elieassjaj/Mach3-based-industrial-CNC-controller/MOTION_ENGINE.md — Motion Engine Requirements and Design Constraints.md

# CNC5AX-ETH Motion Engine

## 1. Purpose

This document defines the **non-negotiable requirements, constraints, interfaces, and design objectives** for the motion-control subsystem of the CNC5AX-ETH controller.

The purpose of this document is **not** to prescribe a specific implementation.

The final motion-engine architecture, algorithms, timer allocation, DMA strategy, buffering mechanism, interpolation method, and real-time scheduling strategy must be selected during firmware development based on:

- Mach3 SDK behavior
- Project requirements
- STM32F407 capabilities
- STM32 official documentation
- Real-time performance analysis
- Determinism
- Measured timing margin
- Reliability and safety

The implementation must satisfy all fixed requirements in this document with a substantial engineering margin.

---

# 2. Target Hardware

```text
MCU:        STM32F407VGT6
CPU:        ARM Cortex-M4 with FPU
Axes:       5
Axes names: X, Y, Z, A, B
```

The authoritative hardware pin assignments are defined in:

```text
Docs/PINOUT.md
```

Do not duplicate or redefine the pin mapping in this document.

The firmware must use `Docs/PINOUT.md` as the authoritative source for the physical MCU pin assignments.

---

# 3. Motion Axes

The controller provides five real motion axes:

```text
X
Y
Z
A
B
```

All five axes are part of the required motion-control subsystem.

The requirement to guarantee three axes at maximum speed does **not** mean that the remaining two axes are optional or lower-priority.

The final implementation must support all five axes.

---

# 4. STEP Outputs

## 4.1 Electrical Behavior

All STEP outputs are:

```text
Active High
```

A STEP event is generated by a transition from:

```text
LOW → HIGH
```

The external stepper/servo drivers are primarily sensitive to the **rising edge** of the STEP signal rather than the exact pulse width.

The STEP output therefore must guarantee a clean and deterministic rising edge.

---

## 4.2 Maximum STEP Rate

The maximum reliable target STEP frequency is:

```text
2 MHz
```

This means a maximum nominal STEP period of:

```text
500 ns
```

The 2 MHz figure is the project-level maximum target for reliable operation and must be treated as a hard performance requirement.

### Multi-Axis Requirement

The motion engine must be designed so that:

```text
At least 3 axes
```

can operate simultaneously at:

```text
2 MHz STEP rate per axis
```

while maintaining reliable and deterministic operation.

This is a **minimum guaranteed capability**.

The remaining two axes must remain fully functional and must not be architecturally disadvantaged simply because the minimum simultaneous 2 MHz requirement is specified for three axes.

A stronger implementation that supports all five axes simultaneously at or near 2 MHz is preferable, but it must not be assumed or claimed without verification.

---

# 5. STEP Pulse Width

The external stepper/servo drivers are primarily sensitive to the rising edge of the STEP signal.

Therefore, the exact STEP pulse width is not a primary system-level constraint.

The design should nevertheless maintain a pulse width comfortably above:

```text
100 ns
```

as a practical safety margin.

The implementation must ensure that the generated pulse is:

- Clean
- Monotonic
- Deterministic
- Free from unintended glitches
- Long enough to satisfy the external driver's requirements

The exact pulse-generation method must be selected by the firmware implementation.

---

# 6. DIR Outputs

All DIR outputs are:

```text
Active High
```

The authoritative DIR pin mapping is defined in:

```text
Docs/PINOUT.md
```

The motion engine must treat the direction signal as a hardware-timed part of the motion-generation system rather than as an unrelated background GPIO operation.

---

# 7. DIR Timing Requirements

The minimum required timing margin for each direction change is:

```text
DIR setup time:  200 ns minimum
DIR hold time:   200 ns minimum
```

The implementation must guarantee at least these values between a DIR transition and the relevant STEP edge.

The actual firmware implementation should preferably provide additional margin rather than operating exactly at the minimum.

Conceptually:

```text
DIR change
    │
    ├────── ≥ 200 ns ──────►
    │
    │                        STEP rising edge
    ▼                              ↑
 DIR stable                first STEP event
```

The exact timing mechanism must be determined during implementation.

Software delays should not be used for hard real-time DIR timing when a deterministic hardware-based mechanism is available.

---

# 8. Hardware Timing Requirement

The STEP/DIR subsystem is a **hard real-time subsystem**.

The final architecture must ensure that Ethernet processing, application-level networking, diagnostics, logging, and other non-real-time operations cannot introduce unacceptable timing variation into STEP generation.

The repository architecture already establishes motion timing as a higher-priority concern than non-real-time processing.

The final implementation must preserve this principle.

---

# 9. STEP Pin Hardware Configuration

All STEP pins are connected to timer alternate-function outputs on the PCB.

According to the project hardware definition:

```text
STEP_X = PD0
STEP_Y = PD1
STEP_Z = PD2
STEP_A = PD3
STEP_B = PD4
```

The current hardware documentation also specifies that these pins are intended for high-speed pulse generation using hardware timers and DMA.

The exact timer/channel mapping must be taken from the authoritative project pinout and verified against the STM32F407 Datasheet and Reference Manual.

Do not infer timer assignments from the GPIO names alone.

---

# 10. Preferred Hardware Generation Strategy

The initial design direction is:

```text
Hardware Timer + DMA
```

However, the project does **not** predefine whether the final implementation must use:

- PWM mode
- Output Compare
- Toggle mode
- One-pulse generation
- DMA-driven GPIO/BSRR updates
- Timer + DMA waveform generation
- A combination of the above
- Another hardware-assisted architecture

The final method must be selected by the implementing AI/engineer based on measured and documented requirements.

### Selection Criteria

The chosen implementation must prioritize:

1. Deterministic STEP timing
2. Deterministic DIR timing
3. Low CPU overhead
4. Low interrupt frequency in the hard real-time path
5. Sufficient DMA bandwidth
6. Sufficient timer resolution
7. Multi-axis synchronization
8. Minimal timing jitter
9. Safe handling of direction changes
10. Reliable operation under maximum Ethernet traffic
11. Sufficient margin above the minimum requirements
12. Maintainability and debuggability

Do not select PWM merely because the pins are connected to timer PWM-capable outputs.

PWM is one possible implementation technique, not a mandatory architectural requirement.

---

# 11. Timer and DMA Architecture Must Be Derived

The final timer and DMA allocation must be determined during implementation.

The implementation must inspect:

```text
STM32F407 Datasheet
STM32F407 Reference Manual
STM32F405/407 Errata
STM32F4 HAL/LL documentation and source
STM32CubeF4 package
Docs/PINOUT.md
```

The implementation must determine:

- Which timers can drive each STEP pin
- Which timer channels correspond to those pins
- Which timers can operate independently
- Which DMA streams/channels can service the required requests
- DMA conflicts
- Timer synchronization options
- Timer clock frequencies
- Counter resolution
- Maximum practical STEP frequency
- DMA transfer rate
- Interrupt load
- Memory requirements
- Inter-axis synchronization capability

No timer or DMA assignment should be hard-coded in project documentation before this analysis has been completed.

---

# 12. Mach3 Command Source

The motion engine receives its motion requirements from the Mach3-side integration.

The exact command semantics must be derived from the **Mach3 SDK included in this repository**.

The implementing AI must inspect:

```text
MACH3/
```

including:

- SDK documentation
- Header files
- API definitions
- Data structures
- Enumerations
- Constants
- Callbacks
- Official examples
- Relevant source code

The project must not assume the structure or meaning of Mach3 motion data based solely on generic knowledge of Mach3.

The SDK README explicitly requires verification of SDK APIs, structures, callbacks, timing behavior, memory ownership, communication mechanisms, and examples before implementation.

---

# 13. Motion Command Interpretation

The exact representation of motion commands is intentionally not fixed in this document.

The final implementation must determine from the Mach3 SDK and project architecture whether the host-side integration provides information such as:

- Position targets
- Position increments
- Velocity
- Step counts
- Trajectory information
- Timing information
- Motion state
- Jog information
- Feed information
- Stop conditions
- Input state
- Other engine-specific data

The firmware must implement the smallest and most deterministic data path necessary to satisfy the actual Mach3 interface requirements.

---

# 14. Motion Planning and Interpolation

The project does not predefine the final mathematical implementation of:

- Multi-axis interpolation
- Velocity profile generation
- Acceleration
- Deceleration
- Jerk limiting
- Look-ahead
- Segment generation
- Trajectory buffering

These decisions must be derived from the actual Mach3 SDK behavior and the resulting host-controller data model.

The implementation must determine which motion responsibilities belong to:

```text
Mach3 / Host PC
```

and which responsibilities must be performed by:

```text
STM32 Motion Engine
```

The same operation must not be unnecessarily duplicated in both systems.

---

# 15. Five-Axis Synchronization

All five axes must be treated as part of one coordinated motion system.

When multiple axes participate in the same motion segment, the generated STEP streams must preserve the required relationship between the axes.

The exact interpolation method must be selected during implementation.

The final implementation should be evaluated for:

- Position accuracy
- Timing accuracy
- Axis synchronization
- Velocity consistency
- Acceleration behavior
- Segment-to-segment continuity
- Maximum step rate
- Jitter
- Buffer behavior

The implementation must not sacrifice multi-axis correctness merely to achieve the maximum STEP rate.

---

# 16. Motion Buffering

The final buffering strategy is intentionally not fixed.

The implementation must determine whether the architecture requires:

- Command buffering
- Trajectory buffering
- Motion segment buffering
- STEP timing buffering
- DMA double buffering
- Ring buffers
- Queue-based scheduling
- Another deterministic buffering mechanism

The size and depth of the buffer must be derived from:

- Mach3 command rate
- Network packet rate
- Worst-case network latency
- Packet loss
- Processing time
- Motion segment duration
- DMA requirements
- Available RAM

The implementation must provide sufficient margin to prevent underflow during normal operation.

---

# 17. Ethernet and Motion Separation

The Ethernet subsystem uses:

```text
LAN8720A
    ↓
RMII
    ↓
STM32F407 Ethernet MAC
    ↓
DMA
    ↓
LwIP
    ↓
UDP
```

The project Ethernet documentation defines the network path and explicitly requires that Ethernet processing must not compromise deterministic motion timing.

The motion engine must therefore be isolated from network processing as much as practical.

The preferred conceptual relationship is:

```text
Ethernet
   │
   ▼
UDP / Protocol
   │
   ▼
Motion Command Buffer
   │
   ▼
Motion Engine
   │
   ▼
Hardware Timer / DMA
   │
   ▼
STEP / DIR
```

The Ethernet callback must not become the STEP-generation mechanism.

---

# 18. Real-Time Priority

The final implementation must assign priorities according to actual timing requirements.

The following general priority principle applies:

```text
Hard real-time motion timing
        ↓
Motion state / critical safety handling
        ↓
Motion data preparation
        ↓
Ethernet processing
        ↓
Diagnostics / non-real-time tasks
```

The exact interrupt priority values must be derived from the final implementation and verified experimentally.

Do not choose priorities arbitrarily.

---

# 19. CPU Load

The motion engine must be designed to leave sufficient CPU resources for:

- Ethernet processing
- LwIP
- Mach3 protocol handling
- I/O handling
- Safety monitoring
- Diagnostics
- Status feedback
- Future firmware expansion

The design must therefore avoid unnecessary high-frequency CPU interrupts.

A solution that technically generates 2 MHz STEP pulses but consumes excessive CPU time is not considered a robust solution.

---

# 20. Jitter

The exact maximum acceptable STEP jitter is currently:

```text
TBD
```

The implementation must nevertheless minimize jitter as much as practical.

The design must not depend on an unverified assumption that the CPU can service a software interrupt every STEP event.

The final system should preferentially use hardware peripherals to control the timing-critical waveform.

Once the motion architecture has been selected, the maximum observed timing deviation must be measured and documented.

---

# 21. Motion Safety

The motion engine must have explicit behavior for safety-related events.

The exact Mach3/software interaction and safety semantics must be derived from the SDK and project requirements.

Potential events include:

- Emergency stop
- Limit switch
- Feed hold
- Normal stop
- Fault condition
- Communication timeout
- Motion buffer underflow
- Invalid motion command

The final implementation must define deterministic behavior for each required event.

No safety-related behavior should be invented silently.

---

# 22. Communication Failure

The exact behavior after:

- Lost packet
- Delayed packet
- Out-of-order packet
- Invalid packet
- Duplicate packet
- Communication timeout
- Ethernet link loss

must be derived from the Mach3 integration and final communication protocol.

Possible behaviors include:

```text
Continue from buffered motion
Controlled stop
Immediate stop
Hold current state
Enter fault state
```

The final implementation must choose behavior based on the actual system requirements and safety analysis.

It must not assume that UDP itself provides delivery guarantees.

---

# 23. Position Tracking

The final implementation must determine from the Mach3 SDK and motion architecture whether the STM32 must maintain:

- Commanded position
- Generated position
- Step count
- Axis position
- Motion segment position
- Host synchronization state

The required representation, width, units, and update mechanism must be determined during implementation.

Use sufficiently wide integer representations where required to prevent overflow during long machine operation.

---

# 24. Direction Handling

Direction changes are part of the hard real-time motion path.

The implementation must guarantee:

```text
DIR setup ≥ 200 ns
DIR hold  ≥ 200 ns
```

around the relevant STEP edge.

The final implementation must ensure that:

- DIR cannot change accidentally during a STEP event
- A direction transition does not create a spurious STEP
- The first STEP after a direction change satisfies the required setup time
- The last STEP before a direction change satisfies the required hold time

The exact implementation method is TBD.

---

# 25. Negative and Positive Motion

Because DIR is Active High, the final implementation must define a consistent relationship between:

```text
Motion direction
        ↓
Axis sign
        ↓
DIR level
```

The exact sign convention must be taken from the final machine configuration and Mach3 integration.

Do not assume:

```text
DIR = 1 → positive
DIR = 0 → negative
```

unless the project hardware and Mach3 configuration explicitly establish that convention.

---

# 26. CoreXY / Kinematic Transformations

The project must not assume that all motion transformation occurs at the Ethernet or protocol layer.

The exact kinematic model must be derived from the final Mach3 configuration and hardware architecture.

If a kinematic transformation such as CoreXY is required, it must be implemented at the appropriate motion-control layer rather than being duplicated across unrelated layers.

The authoritative machine kinematic model must be documented before implementation.

---

# 27. Implementation Independence

The following are intentionally **not fixed** by this document:

```text
Timer mode
PWM vs Output Compare
DMA architecture
DMA buffering
Interrupt frequency
Timer allocation
Motion interpolation algorithm
Acceleration algorithm
Deceleration algorithm
Jerk handling
Buffer depth
Position representation
Communication timeout
Packet scheduling
RTOS vs Bare-Metal
Exact interrupt priorities
```

The AI implementing the final firmware must evaluate these choices against the fixed requirements.

---

# 28. Engineering Objective

The goal is not merely to produce a motion engine that can theoretically reach:

```text
2 MHz
```

The objective is to produce a motion engine that can do so:

- Reliably
- Deterministically
- With low jitter
- With substantial timing margin
- Under maximum expected Ethernet traffic
- With simultaneous multi-axis operation
- Without unsafe race conditions
- Without excessive CPU usage
- Without depending on fragile timing assumptions

The implementation should target **headroom**, not merely the minimum passing condition.

---

# 29. Required Verification

Before considering the motion engine complete, the implementation must be verified experimentally.

At minimum, testing should cover:

### STEP Timing

- Maximum STEP frequency
- Minimum practical frequency
- STEP pulse width
- STEP edge integrity
- Timing jitter

### Multi-Axis Operation

At minimum:

```text
3 axes × 2 MHz STEP
```

must be demonstrated reliably.

The remaining two axes must also be tested under concurrent operation.

Where practical, test:

```text
5 axes simultaneously
```

under representative worst-case conditions.

### DIR Timing

Verify:

```text
DIR setup ≥ 200 ns
DIR hold  ≥ 200 ns
```

under worst-case operating conditions.

### Ethernet Load

Motion timing must be measured while Ethernet is under realistic and worst-case expected traffic.

### CPU Load

Measure CPU utilization during:

- Idle
- Normal motion
- High-rate motion
- Multi-axis motion
- High Ethernet traffic
- Maximum STEP operation

### Stress Conditions

The final design should be tested with combinations of:

```text
Maximum STEP rate
+
Multiple active axes
+
Continuous Ethernet traffic
+
Motion buffer activity
+
I/O activity
+
Status transmission
```

The objective is to verify that the real-time motion subsystem remains deterministic.

---

# 30. Acceptance Criteria

The motion engine is considered compliant only when all fixed requirements are satisfied.

## Mandatory Requirements

| Requirement | Target |
|---|---|
| Axes | X, Y, Z, A, B |
| Maximum STEP rate | 2 MHz |
| Minimum guaranteed simultaneous axes at 2 MHz | 3 |
| STEP polarity | Active High |
| DIR polarity | Active High |
| STEP pulse width | >100 ns preferred practical margin |
| DIR setup time | ≥200 ns |
| DIR hold time | ≥200 ns |
| Timing-critical generation | Hardware-assisted |
| Ethernet impact on STEP timing | Must not compromise determinism |

The minimum guaranteed simultaneous three-axis requirement must be demonstrated on the final hardware.

---

# 31. Documentation Sources

The motion engine implementation must be based on the following sources.

## Project Documentation

```text
Docs/PINOUT.md
Docs/SYSTEM_ARCHITECTURE.md
Docs/ethernet.md
MACH3/SDK_README.MD
```

## STM32 Documentation

```text
STM32_DOCs/
```

including:

- STM32F407 Datasheet
- STM32F407 Reference Manual
- Cortex-M4 Programming Manual
- STM32F405/407 Errata
- Relevant STM32 Application Notes

## Software References

Use the official:

- STM32F4 HAL/LL drivers
- STM32CubeF4 package
- Relevant LwIP documentation/source
- Mach3 SDK included in this repository

---

# 32. AI Development Instructions

This document is specifically intended to guide AI-assisted firmware development.

The AI must follow these rules.

### Rule 1 — Do not change fixed requirements

The values explicitly marked as project requirements must not be changed by the implementation.

This includes:

```text
5 axes
2 MHz maximum target
3 axes minimum simultaneous at 2 MHz
STEP Active High
DIR Active High
DIR setup ≥200 ns
DIR hold ≥200 ns
```

---

### Rule 2 — Do not invent unspecified requirements

If a required value is not defined here, the AI must not silently create one.

Examples:

```text
Maximum jitter
Buffer size
Timer allocation
DMA stream
Interrupt priority
Timeout
Acceleration profile
Communication behavior
```

These must either:

1. Be derived from an authoritative source,
2. Be experimentally determined,
3. Be explicitly proposed as an implementation decision.

---

### Rule 3 — Read the Mach3 SDK before implementing the host interface

The AI must inspect the complete Mach3 SDK material relevant to motion control before defining:

- Motion command structures
- Host-controller synchronization
- Position handling
- Motion timing
- Feed/velocity handling
- Jogging
- Stop behavior
- Input handling
- Feedback

Do not infer these from generic Mach3 knowledge.

---

### Rule 4 — Verify every hardware-dependent decision

Before selecting a timer, DMA stream, channel, GPIO mode, or alternate function, verify it against:

```text
PINOUT.md
+
STM32F407 Datasheet
+
RM0090
+
STM32 Errata
```

---

### Rule 5 — Optimize for margin

The implementation should not be optimized merely to reach the specification boundary.

Where feasible, target:

```text
Required performance
        ↓
Engineering margin
        ↓
Measured worst-case performance
```

The final implementation must retain sufficient margin for:

- Interrupt latency
- DMA contention
- Ethernet traffic
- Memory access
- Future firmware additions
- Worst-case execution paths

---

### Rule 6 — Do not force PWM without analysis

The hardware provides timer alternate-function outputs for the STEP pins.

This does **not** automatically mean PWM is the optimal STEP-generation technique.

The AI must compare appropriate approaches and select the one that provides the best combination of:

- Determinism
- Synchronization
- DMA efficiency
- CPU efficiency
- DIR timing
- Multi-axis scalability
- Reliability

---

### Rule 7 — Prefer hardware timing

When a timing requirement belongs to the STEP/DIR waveform itself, prefer deterministic hardware peripherals over software delays or high-frequency polling.

CPU-based timing must not be selected simply because it is easier to implement.

---

### Rule 8 — Measure before claiming compliance

A theoretical calculation is not sufficient to claim:

```text
3 × 2 MHz
```

or any other final performance target.

The final implementation must be tested on the actual hardware.

---

# 33. Implementation Decision Record

When the final architecture is selected, document the major decisions here or in a dedicated implementation document.

At minimum document:

```text
Timer allocation:
DMA allocation:
STEP generation mode:
DIR generation method:
Motion buffer architecture:
Interpolation method:
Position representation:
Interrupt priorities:
Maximum measured STEP rate:
Maximum measured simultaneous axis rate:
Measured jitter:
Measured CPU load:
Ethernet stress result:
```

This information should be updated after implementation and validation.

---

# 34. Final Design Principle

The motion engine must be treated as the **highest-priority real-time subsystem** of the CNC controller.

The final implementation should follow this principle:

```text
                    MACH3
                      │
                      ▼
                Ethernet / UDP
                      │
                      ▼
               Motion Protocol
                      │
                      ▼
              Motion Processing
                      │
             ┌────────┴────────┐
             ▼                 ▼
        Axis Planning       Buffering
             │                 │
             └────────┬────────┘
                      ▼
              Hardware Timing
              Timer / DMA
                      │
                      ▼
                  STEP / DIR
                      │
              ┌───────┼───────┐
              ▼       ▼       ▼
              X ...           B
```

The network stack, protocol parser, diagnostics, and other non-real-time firmware must be designed around the motion engine rather than allowing them to determine its timing behavior.

The final architecture must satisfy the fixed project requirements while providing substantial real-time performance and reliability margin.
