elieassjaj/Mach3-based-industrial-CNC-controller/Docs/MOTION-ENGINE.md

# CNC5AX-ETH Motion Engine

## 1. Purpose

This document defines the **non-negotiable requirements, constraints, interfaces, and design objectives** for the motion-control subsystem of the CNC5AX-ETH controller.

The purpose of this document is **not** to prescribe a specific implementation.

The final motion-engine architecture, algorithms, timer allocation, DMA strategy, buffering mechanism, interpolation method, and real-time scheduling strategy must be selected during firmware development based on:

- Mach3 SDK behavior
- Project requirements
- STM32F407 capabilities
- STM32 official documentation
- Real-time performance analysis
- Determinism
- Measured timing margin
- Reliability and safety

The implementation must satisfy all fixed requirements in this document with a substantial engineering margin.

---

# 2. Target Hardware

```text
MCU:        STM32F407VGT6
CPU:        ARM Cortex-M4 with FPU
Axes:       5
Axes names: X, Y, Z, A, B
```

The authoritative hardware pin assignments are defined in:

```text
Docs/PINOUT.md
```

Do not duplicate or redefine the pin mapping in this document.

The firmware must use `Docs/PINOUT.md` as the authoritative source for the physical MCU pin assignments.

---

# 3. Motion Axes

The controller provides five real motion axes:

```text
X
Y
Z
A
B
```

All five axes are part of the required motion-control subsystem.

The requirement to guarantee three axes at maximum speed does **not** mean that the remaining two axes are optional or lower-priority.

The final implementation must support all five axes.

---

# 4. STEP Outputs

## 4.1 Electrical Behavior

All STEP outputs are:

```text
Active High
```

A STEP event is generated by a transition from:

```text
LOW → HIGH
```

The external stepper/servo drivers are primarily sensitive to the **rising edge** of the STEP signal rather than the exact pulse width.

The STEP output therefore must guarantee a clean and deterministic rising edge.

---

## 4.2 Maximum STEP Rate

The maximum reliable target STEP frequency is:

```text
2 MHz
```

This means a maximum nominal STEP period of:

```text
500 ns
```

The 2 MHz figure is the project-level maximum target for reliable operation and must be treated as a hard performance requirement.

### Multi-Axis Requirement

The motion engine must be designed so that:

```text
At least 3 axes
```

can operate simultaneously at:

```text
2 MHz STEP rate per axis
```

while maintaining reliable and deterministic operation.

This is a **minimum guaranteed capability**.

The remaining two axes must remain fully functional and must not be architecturally disadvantaged simply because the minimum simultaneous 2 MHz requirement is specified for three axes.

A stronger implementation that supports all five axes simultaneously at or near 2 MHz is preferable, but it must not be assumed or claimed without verification.

---

# 5. STEP Pulse Width

The external stepper/servo drivers are primarily sensitive to the rising edge of the STEP signal.

Therefore, the exact STEP pulse width is not a primary system-level constraint.

The design should nevertheless maintain a pulse width comfortably above:

```text
100 ns
```

as a practical safety margin.

The implementation must ensure that the generated pulse is:

- Clean
- Monotonic
- Deterministic
- Free from unintended glitches
- Long enough to satisfy the external driver's requirements

---

# 6. DIR Outputs

All DIR outputs are:

```text
Active High
```

The authoritative DIR pin mapping is defined in:

```text
Docs/PINOUT.md
```

The motion engine must treat the direction signal as a hardware-timed part of the motion-generation system rather than as an unrelated background GPIO operation.

---

# 7. DIR Timing Requirements

The minimum required timing margin for each direction change is:

```text
DIR setup time:  200 ns minimum
DIR hold time:   200 ns minimum
```

The implementation must guarantee at least these values between a DIR transition and the relevant STEP edge.

The actual firmware implementation should preferably provide additional margin rather than operating exactly at the minimum.

Conceptually:

```text
DIR change
    │
    ├────── ≥ 200 ns ──────►
    │
    │                        STEP rising edge
    ▼                              ↑
 DIR stable                first STEP event
```

The exact timing mechanism must be determined during implementation.

Software delays should not be used for hard real-time DIR timing when a deterministic hardware-based mechanism is available.

---

# 8. Hardware Timing Requirement

The STEP/DIR subsystem is a **hard real-time subsystem**.

The final architecture must ensure that Ethernet processing, application-level networking, diagnostics, logging, and other non-real-time operations cannot introduce unacceptable timing variation into STEP generation.

The repository architecture already establishes motion timing as a higher-priority concern than non-real-time processing.

The final implementation must preserve this principle.

---

# 9. STEP Pin Hardware Configuration

According to the project hardware definition (`Docs/PINOUT.md`):

```text
STEP_X = PA8
STEP_Y = PA9
STEP_Z = PA10
STEP_A = PA11
STEP_B = PA12
```

All five STEP pins are on `GPIOA`, in sequential order (see ADR-005 in `Docs/FIRMWARE-ARCHITECTURE.md`). `PA8`–`PA11` have valid `TIM1_CH1`–`CH4` alternate functions; `PA12` has no TIM1 PWM-channel alternate function (only `TIM1_ETR`). Per Section 10, all five are deliberately configured as plain GPIO outputs and driven via DMA→BSRR rather than via any Alternate Function — because `PA8`–`PA11` share a single `TIM1` ARR (period), which would force axes X, Y, Z, and A onto one common STEP frequency.

The exact DMA stream/mask allocation must be taken from the authoritative project pinout and verified against the STM32F407 Datasheet and Reference Manual.

Do not infer timer/DMA assignments from the GPIO names alone.

---

## 10. STEP Generation Architecture

The STEP generation architecture is fixed as a **timer-triggered DMA to GPIO BSRR** design.

STEP outputs are configured as normal GPIO outputs. Timer PWM, Output Compare, Toggle mode, One-Pulse mode, and CPU-driven GPIO toggling are **not used** for STEP waveform generation.

The motion engine prepares time-ordered STEP events in DMA buffers. DMA transfers precomputed 32-bit values directly to the corresponding GPIO `BSRR` registers.

### Generation Path

```text
Motion Engine
      │
      ▼
STEP Event / BSRR Buffers
      │
      ▼
     DMA
      │
      ▼
GPIOx->BSRR
      │
      ▼
STEP Outputs
```

A base timer provides the deterministic DMA request timing:

```text
Base Timer Update Event
          │
          ▼
         DMA
          │
          ▼
GPIOx->BSRR
```

The timer therefore acts as the **DMA timing/request source**. It does not directly generate the STEP waveform and its output channels are not used as STEP outputs.

### BSRR-Based STEP Events

Each DMA transfer represents a predefined GPIO state transition. The transferred BSRR value may contain:

- GPIO set bits for STEP outputs that must become HIGH
- GPIO reset bits for STEP outputs that must become LOW
- Multiple axis transitions in the same transfer when required

This allows several axes sharing the same timing base to change state deterministically from a single scheduled event.

The STEP GPIO assignments are defined by `Docs/PINOUT.md`.

Current STEP output grouping is:

```text
GPIOA:
    PA8  = X_STEP
    PA9  = Y_STEP
    PA10 = Z_STEP
    PA11 = A_STEP
    PA12 = B_STEP
```

All STEP signals are on `GPIOA`, so the implementation only needs to account for `GPIOA->BSRR` transfers — a single DMA stream and a single 32-bit write per tick covers all five axes.

### Timing Requirements

The STEP generator must support:

- Maximum target STEP frequency: **2 MHz**
- Minimum guaranteed capability: **3 axes simultaneously at 2 MHz**
- STEP active state: HIGH
- Minimum practical STEP pulse width: greater than **100 ns**
- DIR setup time requirement: **200 ns minimum**
- DIR hold time requirement: **200 ns minimum**

At 2 MHz, the nominal STEP period is:

```text
T_STEP = 1 / 2 MHz = 500 ns
```

The implementation must preserve sufficient timing margin and must not depend on CPU execution latency for STEP edge generation.

### Determinism

Once a STEP event buffer has been committed for DMA execution, STEP timing must be independent of:

- Ethernet packet arrival timing
- LwIP processing
- UDP callbacks
- CPU scheduling jitter
- Background diagnostics
- Non-real-time application code

The CPU is responsible for preparing and managing motion data, while the timer-triggered DMA path is responsible for deterministic GPIO state updates.

---

## 11. Timer and DMA Resource Allocation

The STEP-generation architecture is fixed:

```text
Base Timer → DMA Request → GPIOx->BSRR
```

The exact STM32 peripheral allocation remains an implementation detail and must be selected according to the STM32F407VGT6 DMA request mapping, available DMA streams/channels, GPIO port usage, and conflicts with Ethernet and other peripherals.

### Fixed Architectural Requirements

The implementation must satisfy the following:

```text
STEP GPIO mode:
    GPIO Output Push-Pull

STEP waveform generation:
    DMA writes to GPIOx->BSRR

DMA timing source:
    Timer update event

STEP generation:
    Hardware-assisted

CPU-generated STEP edges:
    Not allowed

Timer PWM / Output Compare on STEP pins:
    Not used
```

### DMA Requirements

The DMA implementation must support deterministic writes to the GPIO BSRR registers.

All STEP outputs are on a single GPIO port, so the design needs only one DMA transfer path:

```text
GPIOA->BSRR
```

A single DMA stream, triggered by the base timer's Update event, covers all five axes with zero cross-axis timing skew (see ADR-005 in `Docs/FIRMWARE-ARCHITECTURE.md`). The second `TIM2_UP`-capable DMA1 slot is consequently free and available for a future DIR-DMA path, if the DIR generation method (Section 24/27) is later chosen to use one.

The exact DMA stream/channel selection is **TBD** and must be verified against the STM32F407 DMA mapping and all other active peripherals.

### Timer Requirements

The timer used for STEP DMA triggering must provide a deterministic update-event rate appropriate for the selected motion-event representation.

The timer is a **timing source for DMA requests only**.

The following must not be assumed:

- A timer channel must directly correspond to a STEP GPIO.
- A STEP GPIO must use a timer Alternate Function.
- PWM duty cycle is responsible for STEP pulse width.
- Output Compare directly drives STEP outputs.

Instead, the timer establishes the schedule from which DMA transfers update the GPIO BSRR registers.

### Resource Allocation Constraints

The final allocation must be checked for conflicts with:

- Ethernet MAC/LwIP DMA requirements
- Spindle PWM timer
- Other timer functions
- DMA streams and channels already required by the system
- GPIO availability
- Interrupt resources
- Memory/buffer placement and DMA accessibility

The final Timer/DMA selection is therefore an **implementation decision**, but the underlying architecture is not.

### Validation Requirements

The final implementation must be validated on real hardware for:

1. 2 MHz STEP operation
2. At least 3 axes simultaneously operating at 2 MHz
3. Correct STEP pulse width
4. Correct DIR setup and hold timing
5. Stable operation while Ethernet traffic is active
6. No missed or duplicated STEP events under maximum intended load

The 2 MHz requirement must not be considered verified from simulation, source code inspection, or theoretical timer/DMA capability alone.

---

# 12. Mach3 Command Source

The motion engine receives its motion requirements from the Mach3-side integration.

The exact command semantics must be derived from the **Mach3 SDK included in this repository**.

The implementing AI must inspect:

```text
MACH3/
```

including:

- SDK documentation
- Header files
- API definitions
- Data structures
- Enumerations
- Constants
- Callbacks
- Official examples
- Relevant source code

The project must not assume the structure or meaning of Mach3 motion data based solely on generic knowledge of Mach3.

The SDK README explicitly requires verification of SDK APIs, structures, callbacks, timing behavior, memory ownership, communication mechanisms, and examples before implementation.

---

# 13. Motion Command Interpretation

The exact representation of motion commands is intentionally not fixed in this document.

The final implementation must determine from the Mach3 SDK and project architecture whether the host-side integration provides information such as:

- Position targets
- Position increments
- Velocity
- Step counts
- Trajectory information
- Timing information
- Motion state
- Jog information
- Feed information
- Stop conditions
- Input state
- Other engine-specific data

The firmware must implement the smallest and most deterministic data path necessary to satisfy the actual Mach3 interface requirements.

---

# 14. Motion Planning and Interpolation

The project does not predefine the final mathematical implementation of:

- Multi-axis interpolation
- Velocity profile generation
- Acceleration
- Deceleration
- Jerk limiting
- Look-ahead
- Segment generation
- Trajectory buffering

These decisions must be derived from the actual Mach3 SDK behavior and the resulting host-controller data model.

The implementation must determine which motion responsibilities belong to:

```text
Mach3 / Host PC
```

and which responsibilities must be performed by:

```text
STM32 Motion Engine
```

The same operation must not be unnecessarily duplicated in both systems.

---

# 15. Five-Axis Synchronization

All five axes must be treated as part of one coordinated motion system.

When multiple axes participate in the same motion segment, the generated STEP streams must preserve the required relationship between the axes.

The exact interpolation method must be selected during implementation.

The final implementation should be evaluated for:

- Position accuracy
- Timing accuracy
- Axis synchronization
- Velocity consistency
- Acceleration behavior
- Segment-to-segment continuity
- Maximum step rate
- Jitter
- Buffer behavior

The implementation must not sacrifice multi-axis correctness merely to achieve the maximum STEP rate.

---

# 16. Motion Buffering

The final buffering strategy is intentionally not fixed.

The implementation must determine whether the architecture requires:

- Command buffering
- Trajectory buffering
- Motion segment buffering
- STEP timing buffering
- DMA double buffering
- Ring buffers
- Queue-based scheduling
- Another deterministic buffering mechanism

The size and depth of the buffer must be derived from:

- Mach3 command rate
- Network packet rate
- Worst-case network latency
- Packet loss
- Processing time
- Motion segment duration
- DMA requirements
- Available RAM

The implementation must provide sufficient margin to prevent underflow during normal operation.

---

# 17. Ethernet and Motion Separation

The Ethernet subsystem uses:

```text
LAN8720A
    ↓
RMII
    ↓
STM32F407 Ethernet MAC
    ↓
DMA
    ↓
LwIP
    ↓
UDP
```

The project Ethernet documentation defines the network path and explicitly requires that Ethernet processing must not compromise deterministic motion timing.

The motion engine must therefore be isolated from network processing as much as practical.

The preferred conceptual relationship is:

```text
Ethernet
     │
     ▼
 UDP / Protocol
    │
    ▼
Motion Command Buffer
   │
   ▼
Motion Engine
      ↓
STEP Event / BSRR Buffer
      ↓
     DMA
      ↓
GPIOx->BSRR
      ↓
    STEP
```

The Ethernet callback must not become the STEP-generation mechanism.

---

# 18. Real-Time Priority

The final implementation must assign priorities according to actual timing requirements.

The following general priority principle applies:

```text
Hard real-time motion timing
        ↓
Motion state / critical safety handling
        ↓
Motion data preparation
        ↓
Ethernet processing
        ↓
Diagnostics / non-real-time tasks
```

The exact interrupt priority values must be derived from the final implementation and verified experimentally.

Do not choose priorities arbitrarily.

---

# 19. CPU Load

The motion engine must be designed to leave sufficient CPU resources for:

- Ethernet processing
- LwIP
- Mach3 protocol handling
- I/O handling
- Safety monitoring
- Diagnostics
- Status feedback
- Future firmware expansion

The design must therefore avoid unnecessary high-frequency CPU interrupts.

A solution that technically generates 2 MHz STEP pulses but consumes excessive CPU time is not considered a robust solution.

---

# 20. Jitter

The exact maximum acceptable STEP jitter is currently:

```text
TBD
```

The implementation must nevertheless minimize jitter as much as practical.

The design must not depend on an unverified assumption that the CPU can service a software interrupt every STEP event.

The final system should preferentially use hardware peripherals to control the timing-critical waveform.

Once the motion architecture has been selected, the maximum observed timing deviation must be measured and documented.

---

# 21. Motion Safety

The motion engine must have explicit behavior for safety-related events.

The exact Mach3/software interaction and safety semantics must be derived from the SDK and project requirements.

Potential events include:

- Emergency stop `PE2`
- Limit switch
- Feed hold
- Normal stop
- Fault condition
- Communication timeout
- Motion buffer underflow
- Invalid motion command

The final implementation must define deterministic behavior for each required event.

No safety-related behavior should be invented silently.

---

# 22. Communication Failure

The exact behavior after:

- Lost packet
- Delayed packet
- Out-of-order packet
- Invalid packet
- Duplicate packet
- Communication timeout
- Ethernet link loss

must be derived from the Mach3 integration and final communication protocol.

Possible behaviors include:

```text
Continue from buffered motion
Controlled stop
Immediate stop
Hold current state
Enter fault state
```

The final implementation must choose behavior based on the actual system requirements and safety analysis.

It must not assume that UDP itself provides delivery guarantees.

---

# 23. Position Tracking

The final implementation must determine from the Mach3 SDK and motion architecture whether the STM32 must maintain:

- Commanded position
- Generated position
- Step count
- Axis position
- Motion segment position
- Host synchronization state

The required representation, width, units, and update mechanism must be determined during implementation.

Use sufficiently wide integer representations where required to prevent overflow during long machine operation.

---

# 24. Direction Handling

Direction changes are part of the hard real-time motion path.

The implementation must guarantee:

```text
DIR setup ≥ 200 ns
DIR hold  ≥ 200 ns
```

around the relevant STEP edge.

The final implementation must ensure that:

- DIR cannot change accidentally during a STEP event
- A direction transition does not create a spurious STEP
- The first STEP after a direction change satisfies the required setup time
- The last STEP before a direction change satisfies the required hold time

The exact implementation method is TBD.

---

# 25. Negative and Positive Motion

Because DIR is Active High, the final implementation must define a consistent relationship between:

```text
Motion direction
        ↓
Axis sign
        ↓
DIR level
```

The exact sign convention must be taken from the final machine configuration and Mach3 integration.

Do not assume:

```text
DIR = 1 → positive
DIR = 0 → negative
```

unless the project hardware and Mach3 configuration explicitly establish that convention.

---

# 26. CoreXY / Kinematic Transformations

The project must not assume that all motion transformation occurs at the Ethernet or protocol layer.

The exact kinematic model must be derived from the final Mach3 configuration and hardware architecture.

If a kinematic transformation such as CoreXY is required, it must be implemented at the appropriate motion-control layer rather than being duplicated across unrelated layers.

The authoritative machine kinematic model must be documented before implementation.

---

# 27. Implementation Independence

The following implementation details are intentionally **not fixed** by this document and may be selected during firmware development, provided that all fixed project requirements and architectural constraints are preserved:

```text
DMA stream/channel allocation
DMA buffering mechanism
Interrupt frequency
Exact interrupt priorities

Motion interpolation algorithm
Acceleration algorithm
Deceleration algorithm
Jerk handling
Buffer depth
Position representation

Communication timeout
Packet scheduling

DIR generation implementation
```

The following items were left open by this document but have since been fixed by an Architecture Decision Record in `Docs/FIRMWARE-ARCHITECTURE.md` §41 and must not be silently re-opened without revising that ADR:

```text
STEP-DMA base timer:
    TIM2 (ADR-002) — TIM3 is unavailable, it is committed to Spindle PWM

Firmware execution model:
    Bare-metal, interrupt-driven superloop; no RTOS (ADR-003)
```

The following items are **already fixed by the project architecture and must not be replaced by an alternative STEP-generation architecture**:

```text
STEP generation architecture:
    Timer-triggered DMA → GPIOx->BSRR

STEP output mode:
    Standard GPIO output

STEP waveform generation:
    DMA-driven GPIO BSRR writes

STEP generation:
    Hardware-assisted

CPU-driven STEP generation:
    Not allowed

Timer PWM / Output Compare on STEP pins:
    Not used
```

The implementation may optimize or refine the unfixed items above, but it must not change the fixed STEP-generation architecture unless the project requirements and hardware architecture are explicitly revised.

All implementation decisions must be verified against:

```text
Project requirements
Docs/PINOUT.md
STM32F407 Datasheet
STM32F407 Reference Manual
STM32 Errata
Mach3 SDK
Measured real-time performance
```

The selected implementation must preserve deterministic multi-axis motion, safety, and the required **3 axes at 2 MHz** minimum capability.```

The AI implementing the final firmware must evaluate these choices against the fixed requirements.

---

# 28. Engineering Objective

The goal is not merely to produce a motion engine that can theoretically reach:

```text
2 MHz
```

The objective is to produce a motion engine that can do so:

- Reliably
- Deterministically
- With low jitter
- With substantial timing margin
- Under maximum expected Ethernet traffic
- With simultaneous multi-axis operation
- Without unsafe race conditions
- Without excessive CPU usage
- Without depending on fragile timing assumptions

The implementation should target **headroom**, not merely the minimum passing condition.

---

# 29. Required Verification

Before considering the motion engine complete, the implementation must be verified experimentally.

At minimum, testing should cover:

### STEP Timing

- Maximum STEP frequency
- Minimum practical frequency
- STEP pulse width
- STEP edge integrity
- Timing jitter

### Multi-Axis Operation

At minimum:

```text
3 axes × 2 MHz STEP
```

must be demonstrated reliably.

The remaining two axes must also be tested under concurrent operation.

Where practical, test:

```text
5 axes simultaneously
```

under representative worst-case conditions.

### DIR Timing

Verify:

```text
DIR setup ≥ 200 ns
DIR hold  ≥ 200 ns
```

under worst-case operating conditions.

### Ethernet Load

Motion timing must be measured while Ethernet is under realistic and worst-case expected traffic.

### CPU Load

Measure CPU utilization during:

- Idle
- Normal motion
- High-rate motion
- Multi-axis motion
- High Ethernet traffic
- Maximum STEP operation

### Stress Conditions

The final design should be tested with combinations of:

```text
Maximum STEP rate
+
Multiple active axes
+
Continuous Ethernet traffic
+
Motion buffer activity
+
I/O activity
+
Status transmission
```

The objective is to verify that the real-time motion subsystem remains deterministic.

---

# 30. Acceptance Criteria

The motion engine is considered compliant only when all fixed requirements are satisfied.

## Mandatory Requirements

| Requirement | Target |
|---|---|
| Axes | X, Y, Z, A, B |
| Maximum STEP rate | 2 MHz |
| Minimum guaranteed simultaneous axes at 2 MHz | 3 |
| STEP polarity | Active High |
| DIR polarity | Active High |
| STEP pulse width | >100 ns preferred practical margin |
| DIR setup time | ≥200 ns |
| DIR hold time | ≥200 ns |
| Timing-critical generation | Hardware-assisted |
| Ethernet impact on STEP timing | Must not compromise determinism |

The minimum guaranteed simultaneous three-axis requirement must be demonstrated on the final hardware.

---

# 31. Documentation Sources

The motion engine implementation must be based on the following sources.

## Project Documentation

```text
Docs/PINOUT.md
Docs/SYSTEM-ARCHITECTURE.md
Docs/ETHERNET.md
MACH3/SDK-README.MD
```

## STM32 Documentation

```text
STM32_DOCs/
```

including:

- STM32F407 Datasheet
- STM32F407 Reference Manual
- Cortex-M4 Programming Manual
- STM32F405/407 Errata
- Relevant STM32 Application Notes

## Software References

Use the official:

- STM32F4 HAL/LL drivers
- STM32CubeF4 package
- Relevant LwIP documentation/source
- Mach3 SDK included in this repository

---

# 32. AI Development Instructions

This document is specifically intended to guide AI-assisted firmware development.

The AI must follow these rules.

### Rule 1 — Do not change fixed requirements

The values explicitly marked as project requirements must not be changed by the implementation.

This includes:

```text
5 axes
2 MHz maximum target
3 axes minimum simultaneous at 2 MHz
STEP Active High
DIR Active High
DIR setup ≥200 ns
DIR hold ≥200 ns
```

---

### Rule 2 — Do not invent unspecified requirements

If a required value is not defined here, the AI must not silently create one.

Examples:

```text
Maximum jitter
Buffer size
Timer allocation
DMA stream
Interrupt priority
Timeout
Acceleration profile
Communication behavior
```

These must either:

1. Be derived from an authoritative source,
2. Be experimentally determined,
3. Be explicitly proposed as an implementation decision.

---

### Rule 3 — Read the Mach3 SDK before implementing the host interface

The AI must inspect the complete Mach3 SDK material relevant to motion control before defining:

- Motion command structures
- Host-controller synchronization
- Position handling
- Motion timing
- Feed/velocity handling
- Jogging
- Stop behavior
- Input handling
- Feedback

Do not infer these from generic Mach3 knowledge.

---

### Rule 4 — Verify every hardware-dependent decision

Before selecting a timer, DMA stream, channel, GPIO mode, or alternate function, verify it against:

```text
PINOUT.md
+
STM32F407 Datasheet
+
RM0090
+
STM32 Errata
```

---

### Rule 5 — Optimize for margin

The implementation should not be optimized merely to reach the specification boundary.

Where feasible, target:

```text
Required performance
        ↓
Engineering margin
        ↓
Measured worst-case performance
```

The final implementation must retain sufficient margin for:

- Interrupt latency
- DMA contention
- Ethernet traffic
- Memory access
- Future firmware additions
- Worst-case execution paths

---

### Rule 6 — Prefer hardware timing

When a timing requirement belongs to the STEP/DIR waveform itself, prefer deterministic hardware peripherals over software delays or high-frequency polling.

CPU-based timing must not be selected simply because it is easier to implement.

---

### Rule 7 — Measure before claiming compliance

A theoretical calculation is not sufficient to claim:

```text
3 × 2 MHz
```

or any other final performance target.

The final implementation must be tested on the actual hardware.

---

# 33. Implementation Decision Record

When the final architecture is selected, document the major decisions here or in a dedicated implementation document.

At minimum document:

```text
Timer allocation: TIM2 drives the shared Update-event DMA trigger for STEP generation, PSC=0/ARR=20 → 4 MHz (250 ns) base tick assuming 84 MHz TIM2 clock. TIM3 was rejected as a candidate because TIM3_CH1 (PB4) is already committed to Spindle PWM at a fixed 10 kHz period — see ADR-002 and ADR-004 in Docs/FIRMWARE-ARCHITECTURE.md §41.
DMA allocation: A single DMA1 stream (Stream1/Channel3, triggered by TIM2_UP) → GPIOA->BSRR, covering all five axes (X, Y, Z, A, B — all on GPIOA per ADR-005). Confirmed against RM0090 Rev 22 Table 43 (DMA1 request mapping) — see ADR-002/ADR-004/ADR-005. The Ethernet MAC uses its own dedicated DMA engine (not DMA1/DMA2), so no conflict is expected there. The second TIM2_UP-capable slot (Stream7/Channel3) is left free by this consolidation and is the natural candidate for a future DIR-DMA path (GPIOD->BSRR) if the DIR generation method (below) is later chosen to use one.
STEP generation mode: DMA-driven GPIO BSRR writes (not PWM/Output Compare) — see ADR-001 in Docs/FIRMWARE-ARCHITECTURE.md §41.
Firmware execution model: Bare-metal, interrupt-driven superloop (no RTOS) — see ADR-003 in Docs/FIRMWARE-ARCHITECTURE.md §41.
DIR generation method: CPU-timed GPIO writes on GPIOD, applied in a two-stage fill-time/play-time mechanism synchronized to the DMA half-transfer/transfer-complete (HTIF/TCIF) boundaries of the STEP-DMA buffer (distinct from, and not to be confused with, host-protocol motion segments). A reversal is armed at fill-time; the GPIOD write happens one half-period later, at play-time, with the first g=3 ticks of the target half reserved edge-free for that axis (a cycle-precise setup-margin verification confirms g=2 already sufficient against a ~502 ns worst-case software-latency budget, so g=3 carries roughly 2x margin) - never while the previous half is still autonomously outputting old-direction edges, and the hold side is satisfied unconditionally by a structural >=250 ns gap. Worst-case reversal latency is N x 250 ns, best case (N/2) x 250 ns, where N is the buffer's total tick depth (still open, ADR-008) - both far above the 200 ns setup/hold requirement. The DMA-hardware alternative (freed DMA1_Stream7/Channel3) remains the documented fallback if a motion profile ever needs faster reversals than this range allows. See ADR-006 (fully re-derived, including the cycle-precise verification) and ADR-008 in Docs/FIRMWARE-ARCHITECTURE.md §41.
Motion buffer architecture: Two independent buffers — a small fixed-size STEP-DMA refill buffer (size TBD, tuned after hardware measurement), and a motion command buffer targeting >=128 ms of buffered motion (evidence-based target from the Mach3 SDK's ncPod reference device, Docs/MACH3-INTERFACE.md §4), statically allocated. Underflow -> controlled halt + FAULT (not EMERGENCY_STOP); overflow -> explicit backpressure, never silent overwrite. Exact command encoding and final depth remain blocked on the UDP protocol — see ADR-008 in Docs/FIRMWARE-ARCHITECTURE.md §41.
Interpolation method: Per-axis DDA/Bresenham accumulator at the 4 MHz base tick, fed by step-domain (not engineering-unit) time-sliced velocity commands; all mm/inch<->step conversion happens on the PC-side Mach3 plugin, never in firmware — see ADR-007 in Docs/FIRMWARE-ARCHITECTURE.md §41.
Position representation: int64_t, raw step counts (not engineering units) — matches the SDK's own GMoves.DDA1/2/3 field width (__int64) and permanently avoids overflow at the fixed 2 MHz maximum rate — see ADR-009 in Docs/FIRMWARE-ARCHITECTURE.md §41.
Interrupt priorities: Fixed for the peripherals configured so far — EXTI2 (E-STOP) highest, other EXTI next, DMA1 Stream1 (STEP refill) next, ETH lower, SysTick lowest, TIM2 global interrupt disabled — see ADR-004 in Docs/FIRMWARE-ARCHITECTURE.md §41. Priorities for not-yet-configured peripherals (including a possible future DMA1 Stream7 for DIR) remain TBD.
Maximum measured STEP rate: TBD — not yet tested on hardware.
Maximum measured simultaneous axis rate: TBD — not yet tested on hardware.
Measured jitter: TBD.
Measured CPU load: TBD.
Ethernet stress result: TBD.
```

## Phase 1 implementation status (2026-09-16)

The block above records the decisions as frozen before coding. Phase 1
implemented them; the table below is what the code actually does and where
it differs. Full reasoning is in `Docs/FIRMWARE-ARCHITECTURE.md` §41.

| Item | As built | Status |
|---|---|---|
| Base tick | 4.000 MHz exactly, PSC = 0 | As decided (ADR-004) |
| Timer | **TIM8** (APB2, 168 MHz, ARR = 41) | **DEVIATES from TIM2** — see ADR-012 |
| DMA | **DMA2 Stream 1, Channel 7 (`TIM8_UP`)** → `GPIOA->BSRR` | **DEVIATES from DMA1 Stream1** — RM0090 §2.1 / Fig 33 / §10.3.16: DMA1's peripheral port is not a bus-matrix master and cannot reach GPIO at all. ADR-012. Needs an owner decision and an `.ioc` change |
| Stream config | memory→peripheral, 32/32-bit, MINC, PINC off, circular, HT+TC+TE+DME interrupts, very high priority, direct mode (FIFO off) | As decided (ADR-004) |
| STEP pins | PA8..PA12, single port, one BSRR word per tick | As decided (ADR-005) |
| STEP pulse width | exactly one tick = 250 ns | As decided; HV-10 measures |
| Execution model | bare-metal, interrupt-driven | As decided (ADR-003) |
| DIR generation | CPU-timed `GPIOD` writes, two-stage arm-at-fill / write-at-play, `g = 3` guard ticks | As decided (ADR-006) |
| DIR armed-slot depth | one per axis; a second reversal **stalls the new segment** rather than overwriting the pending one | As decided (ADR-006). Implementing this exposed a defect in a first cut that overwrote instead of waiting, which silently ran the axis the wrong way; a regression test now covers it |
| Interpolation | 32-bit DDA phase accumulator per axis, step domain, increment clamped to 2^31 | As decided (ADR-007) |
| Position | `int64_t` step counts; `pos_planned` and `pos_output` tracked separately | As decided (ADR-009) |
| STEP-DMA buffer depth N | **1024 ticks** (256 µs ring, 128 µs refill deadline, 4 KB, 7.8 kHz ISR, reversal latency 128–256 µs) | ADR-008 left this **OPEN**; 1024 is a documented default, not a decision. HV-04 informs the final value |
| Motion command buffer | 64 segment slots, lock-free SPSC, push refused when full (backpressure, never overwrite) | As decided (ADR-008). The ≥128 ms target depends on the Phase 3 slice duration and cannot be fixed yet |
| Underflow | hard integrity fault + stop + `EN` deasserted; never a stale replay | As decided (ADR-008/ADR-010) |
| Starvation / comm pause | position held, STEP stops, **`EN` stays asserted** | As decided (ADR-010, owner-confirmed) |
| State model | `SAFE_IDLE → READY ⇄ RUNNING`, `FAULT`, latching `EMERGENCY_STOP`; recovery always explicit; a fault-clear can never clear an E-stop | As decided (ADR-010) |
| Interrupt priorities | E-STOP 0, other inputs 1, STEP-DMA 2, Ethernet 5 | As decided (ADR-004); vector is `DMA2_Stream1_IRQn` per ADR-012 |
| Ring memory | SRAM2 (`.stepgen_ram`, NOLOAD), separate bus-matrix slave from the SRAM1 Ethernet will use | New; ADR-002's isolation intent made concrete. HV-03 verifies placement |
| Maximum measured STEP rate | TBD — not tested on hardware | HV-10 |
| Maximum measured simultaneous axis rate | TBD — not tested on hardware | HV-11 (the §30 requirement) |
| Measured jitter | TBD — §20 leaves the limit TBD; HV-11 should measure it and set it | HV-11 |
| Measured CPU load | TBD. Estimated ~25 Cortex-M4 cycles/tick ≈ 60% duty at the 4 MHz tick, from generated-code inspection. **Above the 50% target; the main open risk** | HV-04, RISK-1 |
| Ethernet stress result | TBD — requires Phase 2 | HV-15 |

This information should be updated after implementation and validation.

---

# 34. Final Design Principle

The motion engine must be treated as the **highest-priority real-time subsystem** of the CNC controller.

The final implementation should follow this principle:

```text
                    MACH3
                      │
                      ▼
                Ethernet / UDP
                      │
                      ▼
               Motion Protocol
                      │
                      ▼
              Motion Processing
                      │
             ┌────────┴────────┐
             ▼                 ▼
        Axis Planning       Buffering
             │                 │
             └────────┬────────┘
                      ▼
           DMA →  GPIOx->BSRR   ← Base Timer Update Event
                      │
                      ▼
                  STEP / DIR
                      │
              ┌───────┼───────┐
              ▼       ▼       ▼
              X ...           B
```

The network stack, protocol parser, diagnostics, and other non-real-time firmware must be designed around the motion engine rather than allowing them to determine its timing behavior.

The final architecture must satisfy the fixed project requirements while providing substantial real-time performance and reliability margin.
