elieassjaj/Mach3-based-industrial-CNC-controller/(list of files, cad)

Other CAD files:
MACH3/Mach3 Software Development Kit(SDK)/SDK/Galil PlugIn/LocalIPQuery.obj
MACH3/Mach3 Software Development Kit(SDK)/SDK/Galil PlugIn/MachDevice.obj
MACH3/Mach3 Software Development Kit(SDK)/SDK/Galil PlugIn/ExternalMovement.obj
MACH3/Mach3 Software Development Kit(SDK)/SDK/Galil PlugIn/UDPSocket.obj
MACH3/Mach3 Software Development Kit(SDK)/SDK/Galil PlugIn/G100Monitor.obj
MACH3/Mach3 Software Development Kit(SDK)/SDK/Galil PlugIn/G100General.obj
MACH3/Mach3 Software Development Kit(SDK)/SDK/Galil PlugIn/G100Config.obj
MACH3/Mach3 Software Development Kit(SDK)/SDK/Galil PlugIn/XMLProfile.obj
MACH3/Mach3 Software Development Kit(SDK)/SDK/Galil PlugIn/Dmcwin.obj
MACH3/Mach3 Software Development Kit(SDK)/SDK/Galil PlugIn/MachDevImplementation.obj
MACH3/Mach3 Software Development Kit(SDK)/SDK/Galil PlugIn/stdafx.obj
MACH3/Mach3 Software Development Kit(SDK)/SDK/Galil PlugIn/Monitoring.obj
MACH3/Mach3 Software Development Kit(SDK)/SDK/Galil PlugIn/MessageTracker.obj
MACH3/Mach3 Software Development Kit(SDK)/SDK/Galil PlugIn/Decoders.obj
MACH3/Mach3 Software Development Kit(SDK)/SDK/Galil PlugIn/G100FLASHCONFIG.obj
