elieassjaj/Mach3-based-industrial-CNC-controller/prototype_test/prototype_sch.pdf

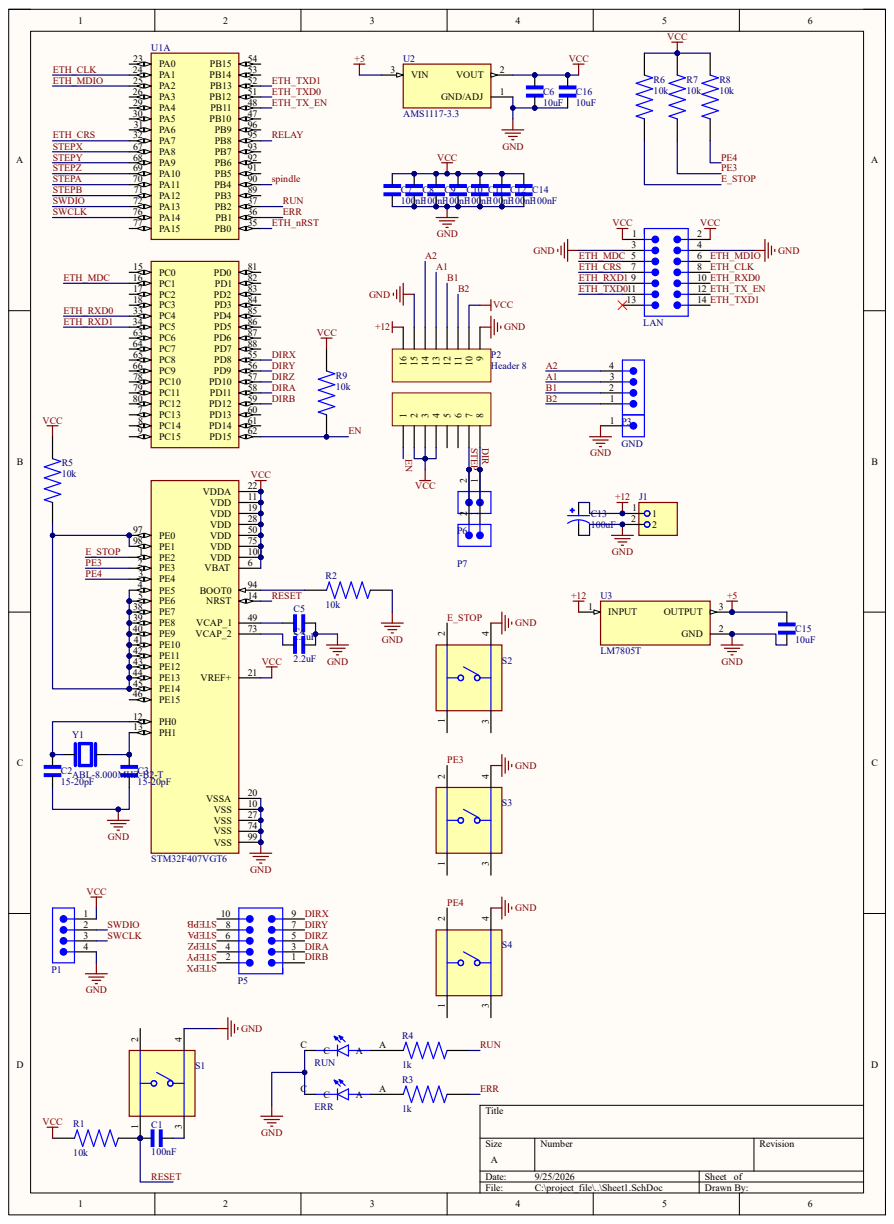
[picture p3: page 1]
