elieassjaj/Mach3-based-industrial-CNC-controller/Firmware/LWIP/App/lwip.c

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

/* Includes ------------------------------------------------------------------*/
#include "lwip.h"
#include "lwip/init.h"
#include "lwip/netif.h"
#if defined ( __CC_ARM )  /* MDK ARM Compiler */
#include "lwip/sio.h"
#endif /* MDK ARM Compiler */
#include "ethernetif.h"

/* USER CODE BEGIN 0 */
#include "net_glue.h"
/* USER CODE END 0 */
static void ethernet_link_status_updated(struct netif *netif);
static void Ethernet_Link_Periodic_Handle(struct netif *netif);
/* ETH Variables initialization ----------------------------------------------*/
void Error_Handler(void);

uint32_t EthernetLinkTimer;

/* Variables Initialization */
struct netif gnetif;
ip4_addr_t ipaddr;
ip4_addr_t netmask;
ip4_addr_t gw;

/**
  * LwIP initialization function
  */
void MX_LWIP_Init(void)
{
  /* Initialize the LwIP stack without RTOS */
  lwip_init();

  /* IP addresses initialization without DHCP (IPv4) */
  IP4_ADDR(&ipaddr, IP_ADDR0, IP_ADDR1, IP_ADDR2, IP_ADDR3);
  IP4_ADDR(&netmask, NETMASK_ADDR0, NETMASK_ADDR1, NETMASK_ADDR2, NETMASK_ADDR3);
  IP4_ADDR(&gw, GW_ADDR0, GW_ADDR1, GW_ADDR2, GW_ADDR3);

  /* add the network interface (IPv4/IPv6) without RTOS */
  netif_add(&gnetif, &ipaddr, &netmask, &gw, NULL, &ethernetif_init, &ethernet_input);

  /* Registers the default network interface */
  netif_set_default(&gnetif);

  /* We must always bring the network interface up connection or not... */
  netif_set_up(&gnetif);

  /* Set the link callback function, this function is called on change of link status*/
  netif_set_link_callback(&gnetif, ethernet_link_status_updated);

/* USER CODE BEGIN 3 */
  /* Apply the static address from Net/Inc/net_config.h, whatever the
   * generated code above did. This block is the one that survives a CubeMX
   * regeneration, and the regression it guards against has already happened
   * once here: the static configuration was lost in b409ba5 and the device
   * would have come up on 0.0.0.0, waiting for a DHCP server that does not
   * exist on this link. HV-24 fails if this is ever dropped. */
  net_glue_apply_static_ip();
/* USER CODE END 3 */
}

#ifdef USE_OBSOLETE_USER_CODE_SECTION_4
/* Kept to help code migration. (See new 4_1, 4_2... sections) */
/* Avoid to use this user section which will become obsolete. */
#endif

/**
  * @brief  Ethernet Link periodic check
  * @param  netif
  * @retval None
  */
static void Ethernet_Link_Periodic_Handle(struct netif *netif)
{
  /* Ethernet Link every 100ms */
  if (HAL_GetTick() - EthernetLinkTimer >= 100)
  {
    EthernetLinkTimer = HAL_GetTick();
    ethernet_link_check_state(netif);
  }
/* USER CODE BEGIN 4_4 */
  /* Sample the link that ethernet_link_check_state() has just reconciled,
   * so the rest of the firmware can read link state without touching lwIP.
   * This block runs at main-loop rate, not every 100 ms - the call rate-
   * limits itself, keeping that logic in project-owned code rather than in
   * a marker CubeMX would not preserve. */
  net_glue_poll_link();
/* USER CODE END 4_4 */
}

/**
 * ----------------------------------------------------------------------
 * Function given to help user to continue LwIP Initialization
 * Up to user to complete or change this function ...
 * Up to user to call this function in main.c in while (1) of main(void)
 *-----------------------------------------------------------------------
 * Read a received packet from the Ethernet buffers
 * Send it to the lwIP stack for handling
 * Handle timeouts if LWIP_TIMERS is set and without RTOS
 * Handle the llink status if LWIP_NETIF_LINK_CALLBACK is set and without RTOS
 */
void MX_LWIP_Process(void)
{
  ethernetif_input(&gnetif);

  /* Handle timeouts */
  sys_check_timeouts();

  Ethernet_Link_Periodic_Handle(&gnetif);

}

/**
  * @brief  Notify the User about the network interface config status
  * @param  netif: the network interface
  * @retval None
  */
static void ethernet_link_status_updated(struct netif *netif)
{
  if (netif_is_up(netif))
  {
  }
  else /* netif is down */
  {
  }
}

#if defined ( __CC_ARM )  /* MDK ARM Compiler */
/**
 * Opens a serial device for communication.
 *
 * @param devnum device number
 * @return handle to serial device if successful, NULL otherwise
 */
sio_fd_t sio_open(u8_t devnum)
{
  sio_fd_t sd;

/* USER CODE BEGIN 7 */
  sd = 0; // dummy code
/* USER CODE END 7 */

  return sd;
}

/**
 * Sends a single character to the serial device.
 *
 * @param c character to send
 * @param fd serial device handle
 *
 * @note This function will block until the character can be sent.
 */
void sio_send(u8_t c, sio_fd_t fd)
{
}

/**
 * Reads from the serial device.
 *
 * @param fd serial device handle
 * @param data pointer to data buffer for receiving
 * @param len maximum length (in bytes) of data to receive
 * @return number of bytes actually received - may be 0 if aborted by sio_read_abort
 *
 * @note This function will block until data can be received. The blocking
 * can be cancelled by calling sio_read_abort().
 */
u32_t sio_read(sio_fd_t fd, u8_t *data, u32_t len)
{
  u32_t recved_bytes;

/* USER CODE BEGIN 9 */
  recved_bytes = 0; // dummy code
/* USER CODE END 9 */
  return recved_bytes;
}

/**
 * Tries to read from the serial device. Same as sio_read but returns
 * immediately if no data is available and never blocks.
 *
 * @param fd serial device handle
 * @param data pointer to data buffer for receiving
 * @param len maximum length (in bytes) of data to receive
 * @return number of bytes actually received
 */
u32_t sio_tryread(sio_fd_t fd, u8_t *data, u32_t len)
{
  u32_t recved_bytes;

/* USER CODE BEGIN 10 */
  recved_bytes = 0; // dummy code
/* USER CODE END 10 */
  return recved_bytes;
}
#endif /* MDK ARM Compiler */
