elieassjaj/Mach3-based-industrial-CNC-controller/Firmware/LWIP/App/lwip.h

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
/* Define to prevent recursive inclusion -------------------------------------*/
#ifndef __mx_lwip_H
#define __mx_lwip_H
#ifdef __cplusplus
 extern "C" {
#endif

/* Includes ------------------------------------------------------------------*/
#include "lwip/opt.h"
#include "lwip/mem.h"
#include "lwip/memp.h"
#include "netif/etharp.h"
#include "lwip/dhcp.h"
#include "lwip/netif.h"
#include "lwip/timeouts.h"
#include "ethernetif.h"

/* Includes for RTOS ---------------------------------------------------------*/
#if WITH_RTOS
#include "lwip/tcpip.h"
#endif /* WITH_RTOS */

/* IP addresses initialization without DHCP (IPv4) */
/* CNC5AX-ETH static address, direct point-to-point link to the Mach3 PC.
 * These are CubeMX's own template macros, regenerated from the .ioc. The
 * authoritative copy of these values is Net/Inc/net_config.h, which
 * net_glue_apply_static_ip() applies at the end of MX_LWIP_Init() - so the
 * interface still comes up correctly if a regeneration loses this block.
 * See Docs/ETHERNET.md Section 15. */
#define IP_ADDR0   ((uint8_t) 192U)
#define IP_ADDR1   ((uint8_t) 168U)
#define IP_ADDR2   ((uint8_t) 5U)
#define IP_ADDR3   ((uint8_t) 10U)

/*NETMASK*/
#define NETMASK_ADDR0   ((uint8_t) 255U)
#define NETMASK_ADDR1   ((uint8_t) 255U)
#define NETMASK_ADDR2   ((uint8_t) 255U)
#define NETMASK_ADDR3   ((uint8_t) 0U)

/*Gateway Address*/
#define GW_ADDR0   ((uint8_t) 0U)
#define GW_ADDR1   ((uint8_t) 0U)
#define GW_ADDR2   ((uint8_t) 0U)
#define GW_ADDR3   ((uint8_t) 0U)

/* Global Variables ----------------------------------------------------------*/
extern ETH_HandleTypeDef heth;

/* LWIP init function */
void MX_LWIP_Init(void);

#if !WITH_RTOS
/* USER CODE BEGIN 1 */
/* Function defined in lwip.c to:
 *   - Read a received packet from the Ethernet buffers
 *   - Send it to the lwIP stack for handling
 *   - Handle timeouts if NO_SYS_NO_TIMERS not set
 */
void MX_LWIP_Process(void);

/* USER CODE END 1 */
#endif /* WITH_RTOS */

#ifdef __cplusplus
}
#endif
#endif /*__ mx_lwip_H */

/**
  * @}
  */

/**
  * @}
  */
