elieassjaj/Mach3-based-industrial-CNC-controller/(commit log)

2026-09-06 ADD STM32 DOCS
2026-09-06 Update PINOUT.md with STEP pins PWM connection info
    Added note about STEP pins being connected to PWM outputs.
2026-09-06 Add STM32F407VG datasheet
    Added comprehensive datasheet for STM32F407VG microcontroller, detailing device specifications, pinout, electrical characteristics, and usage guidelines.
2026-09-06 Rename STM32_DOCs/stm32_application note_AN3966.pdf to STM32_DOCs/application note/stm32_application note_AN3966.pdf
2026-09-06 Rename MOTION_ENGINE.md — Motion Engine Requirements and Design Constraints.md to Docs/MOTION_ENGINE.md — Motion Engine Requirements and Design Constraints.md
2026-09-07 Rename MOTION_ENGINE.md — Motion Engine Requirements and Design Constraints.md to MOTION_ENGINE.md
2026-09-07 Rename FIRMWARE_ARCHITECTURE.md — CNC5AX-ETH Firmware Architecture.md to FIRMWARE_ARCHITECTURE.md
2026-09-07 Document five-axis motion architecture and control
    Added detailed architecture and control mechanisms for a five-axis motion system, including independent axis control, motion planning, and hardware timer interface.
2026-09-08 Create STM32-DOCs
2026-09-09 Revise STEP pins configuration for GPIO ports
    Updated STEP pins section to reflect changes in GPIO ports and DMA handling.
2026-09-09 Update STEP/DIR interface and pin assignments in README
2026-09-09 Revise STEP pin configuration and usage notes
    Updated STEP pin configuration details and clarified usage of GPIO and DMA.
2026-09-09 Document STEP pulse generation method in ADR-001
    Added ADR-001 detailing the STEP pulse generation method for axes using a shared base timer and DMA transfers. Discussed decision rationale, alternatives considered, and impacts on timing, memory, CPU, and risks.
2026-09-09 Enhance MOTION-ENGINE.md with detailed allocations
    Updated the MOTION-ENGINE documentation with specific details on timer and DMA allocation, STEP generation mode, and other parameters.
2026-09-10 Change STEP pin assignments in PINOUT.md
    Updated pin assignments for STEP functions in the STM32F407VGT6.
2026-09-10 Update Timer/DMA section in README
2026-09-10 Update README with timer/DMA and STEP architecture details
    Clarify final timer/DMA allocation and describe STEP generation architecture.
2026-09-10 Revise STEP generation architecture details
    Updated the STEP generation architecture to clarify the use of DMA-driven GPIO updates and removed unnecessary details about timer configurations.
2026-09-11 Update timer candidates for STEP generation
2026-09-11 Remove Rule 6 and update hardware timing details
    Removed Rule 6 regarding PWM analysis and updated related sections.
2026-09-11 Revise STEP generation architecture and requirements
    Updated the section on STEP generation architecture to clarify the use of timer-triggered DMA for GPIO BSRR. Added details on timing requirements, resource allocation, and validation requirements for the implementation.
2026-09-11 Fix broken cross-document references and dangling rule stub
    - README.md, FIRMWARE-ARCHITECTURE.md, MOTION-ENGINE.md referenced
    MACH3/SDK_README.MD, Docs/ethernet.md, Docs/SYSTEM_ARCHITECTURE.md
    and Docs/MOTION_ENGINE.md — none of which match the real filenames
    (SDK-README.MD, ETHERNET.md, SYSTEM-ARCHITECTURE.md, MOTION-ENGINE.md).
    Corrected all instances so every cross-reference/link resolves.
    - README.md repo tree listed STM32_DOCs/application note/ (space)
    instead of the real application_note/ folder.
    - MOTION-ENGINE.md left an empty "Rule 6 — This item has been removed."
    stub after ADR-001 made the old PWM-selection rule moot; removed the
    stub and renumbered the followin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
2026-09-11 Lock TIM2 for STEP-DMA, decide bare-metal execution model, document SWD/PB4 dependency
    - ADR-002 (FIRMWARE-ARCHITECTURE.md): select TIM2 as the STEP-generation
    base timer. TIM3 is ruled out because TIM3_CH1/PB4 is already committed
    to the fixed 10 kHz Spindle PWM, which would recreate the shared-ARR
    conflict ADR-001 already rejected for TIM1. Notes the expected DMA1
    Stream1/Stream7 Channel3 mapping for TIM2_UP, and flags that the RM0090
    PDF in this repo is a 2-byte placeholder so the exact stream/channel
    still needs verification against a real copy.
    - ADR-003 (FIRMWARE-ARCHITECTURE.md): decide bare-metal, interrupt-driven
    superloop over FreeRTOS. STEP timing is already hardware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
2026-09-12 Confirm TIM2/DMA1 mapping against real RM0090, add ADR-004 (TIM2/DMA/NVIC config)
    Now that the real STM32F407 Datasheet/RM0090/Errata PDFs are uploaded,
    verified the TIM2_UP DMA1 request mapping directly against RM0090 Rev 22
    Table 43: TIM2_UP is available on both DMA1 Stream1/Channel3 and
    DMA1 Stream7/Channel3, confirming the two-stream STEP-DMA plan from
    ADR-002. Also confirmed TIM2 is a 32-bit APB1 timer and the RCC "APBx
    timer clock = APBx clock x2 when prescaler != 1" rule from RM0090
    Figure 16.
    - ADR-002: replaced the "pending RM0090 verification" caveat with the
    confirmed Stream1->GPIOA / Stream7->GPIOC assignment.
    - ADR-004 (new): TIM2 PSC=0/ARR=20 for a 4 MHz (250 ns) base tick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
2026-09-12 Consolidate STEP pins onto GPIOA (PA8-PA12), add ADR-005
    Move STEP_X from PC9 to PA12, keeping STEP_Y..STEP_B on PA8-PA11, per
    X=PA8, Y=PA9, Z=PA10, A=PA11, B=PA12. All five STEP pins are now on a
    single GPIO port and require only one DMA stream.
    Motivation: CubeMX's per-peripheral DMA Settings tab (e.g. TIM2's) can
    only link a given request type such as TIM2_UP to one stream — there is
    no GUI path to add the same request a second time. The previous
    two-port design (X on PC9/GPIOC, Y/Z/A/B on GPIOA) needed two streams
    both sourced by TIM2_UP, which is exactly what that tab cannot do. This
    also eliminates cross-port DMA arbitration skew between axes (now a
    single 32-bit GPIOA->BSRR write u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
2026-09-13 Add initial STM32CubeIDE firmware project
2026-09-13 Update README to reflect the actual Firmware/ project state
    The CubeMX/CubeIDE project is now in the repository, so the README's
    Firmware/ placeholder and status table no longer matched reality.
    - Repository Structure: replaced the "STM32CubeIDE firmware project"
    placeholder with the actual tree (Core/, Drivers/, LWIP/, Middlewares/,
    linker scripts, .ioc, project files) and added .gitignore.
    - New "Firmware Project State" section recording what the generated
    configuration actually establishes (clock, STEP/DIR GPIO, TIM2 4 MHz
    base tick, DMA1_Stream1/Ch3, TIM3 10 kHz spindle PWM, EXTI/NVIC
    priorities, ETH RMII, LwIP NO_SYS/RAW) and stating plainly that it is
    peripheral initializa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
2026-09-14 Update hardware timer references to include DMA and BSRR
2026-09-14 Record EN polarity, input pull-ups, verified PHY hardware facts, and Mach3 host interface
    - PINOUT.md: EN (PD15) is ACTIVE HIGH (HIGH = drives enabled). Records the
    start-up consequence: PD15 must be LOW out of reset so the drives stay
    disabled until initialization completes, which the generated
    MX_GPIO_Init() already does.
    - PINOUT.md: the board fits external pull-ups on all 15 inputs, so
    GPIO_NOPULL is the correct configuration and internal pulls must not be
    enabled. Also records the both-edges EXTI trigger and why.
    - ETHERNET.md 20.5: the previous fix removed the PWM wording but the
    section still showed one timer/DMA path per axis. Replaced with the
    actual topology - one TIM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
2026-09-15 Updated LAN8720A/LwIP configuration: PB0 reset release, LAN8742-compatible driver selection, MX_LWIP_Process() integration, and regenerated Firmware files.
    [CNC5AX-ETH.ioc, main.c]
2026-09-15 Verify PB0/LAN8742/MX_LWIP_Process changes; document PHY reset timing
    Reviewed the regenerated Firmware/ files (.ioc, gpio.c, main.c,
    ethernetif.c, stm32f4xx_hal_conf.h, new lan8742.c/.h, .cproject/
    .mxproject/language.settings.xml) against the three requested changes.
    All three are correct, minimal, and standard CubeMX output:
    - PB0/PHY_NRST is now GPIO_PIN_SET with internal pull-up, set before
    MX_LWIP_Init() runs - releases the PHY from reset as required.
    - LAN8742 driver added under Drivers/BSP/Components/lan8742 and wired
    into ethernetif.c (ETH_PHY_IO_* callbacks, HAL_ETH_MspInit with the
    same nine RMII pins and ETH_IRQn/ETH_WKUP_IRQn at priority 5, matching
    ADR-004) and etherne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
2026-09-15 Resolve DHCP vs static-IP: switch to static IPv4 (192.168.5.10/24)
    Decision: dedicated, isolated point-to-point link between the
    controller and one Mach3 PC NIC, no DHCP server ever present, so DHCP
    would never complete. Static addressing on both ends is required.
    Chose 192.168.5.0/24 specifically to avoid the two most common
    home/office router defaults (192.168.0.0/24, 192.168.1.0/24), so a
    collision is unlikely regardless of how the PC's other network
    adapters are configured. No gateway (0.0.0.0) - nothing outside the
    /24 needs to be reached on an isolated link.
    Controller: 192.168.5.10 / 255.255.255.0
    Host PC: 192.168.5.100 / 255.255.255.0
    Firmware (Firmware/LWIP/):
    - lwipopts.h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
    [CNC5AX-ETH.ioc, lwip.c, lwip.h]
2026-09-15 Add firmware implementation plan (planning only, no code)
    Pre-coding planning pass requested before writing any firmware logic.
    Docs/FIRMWARE-IMPLEMENTATION-PLAN.md:
    - Breaks the firmware into 15 modules (M1-M15) under the source tree
    already suggested in FIRMWARE-ARCHITECTURE.md Section 43, each mapped
    to the exact doc/ADR section that requires it.
    - Separates protocol-independent modules (safety, motion/StepGen,
    DIR, spindle, relay, Ethernet link bring-up) from the ones that
    cannot be finished until the Mach3 UDP protocol is designed
    (UDP socket, protocol parser, the planner's producer side, the
    feedback path, the PC-side plugin) - no port number, packet format,
    MAC scheme,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
2026-09-15 Resolve 6 of 8 pre-implementation decisions; flag the rest for explicit owner decision
    Adds ADR-006 through ADR-011 to Docs/FIRMWARE-ARCHITECTURE.md Section 41,
    each following the existing ADR format (Decision/Reason/Alternatives/
    Timing/Memory/CPU impact/Risks/Validation), and a new scannable
    companion Docs/PRE-IMPLEMENTATION-DECISIONS.md that answers, per item:
    documented requirement, what was undecided, downstream module
    dependents, resolution (or explicit open question).
    Resolved from repository evidence, no invention:
    - ADR-006 DIR generation: CPU-timed GPIOD writes with a one-base-tick
    (250ns) guard interval, exceeding the 200ns setup/hold requirement;
    DMA-hardware path kept as do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
2026-09-15 Apply project-owner decisions: relay polarity, fault recovery, MAC strategy
    Records four decisions made by the project owner in response to the
    open questions from the previous pre-implementation-decisions pass:
    - Relay (PB8): ACTIVE HIGH, verified against the actual hardware.
    Docs/PINOUT.md no longer carries the verification-required flag.
    - Fault recovery policy: confirmed as "always explicit, never
    automatic" - matches ADR-010's original conservative default, now
    stated as decided rather than proposed.
    - Comm-timeout / buffer-underflow behavior: revised from ADR-010's
    original default. These two FAULT categories now hold position with
    EN still asserted rather than disabling dri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
2026-09-15 Fully re-derive ADR-006 DIR mechanism: precise boundary, latency as f(N), no stale-STEP guarantee
    Follow-up precision pass on the DIR mechanism, per explicit request not
    to conflate a DMA hardware boundary with a host-protocol motion
    segment, and to derive worst-case latency as a function of the actual
    buffer structure rather than asserting a fixed "one refill period".
    Precise boundary definition: DMA half-buffer boundaries are exactly
    DMA1_Stream1's Half-Transfer (HTIF) and Transfer-Complete/wrap (TCIF)
    interrupts - the only two hardware-synchronized instants available to
    CPU-timed code, since there is no mechanism to synchronize a plain GPIO
    write to an arbitrary mid-half tick without a s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
2026-09-16 Cycle-precise verification of ADR-006's play-time DIR guard interval g
    Answers the follow-up request to prove (not merely estimate) that the
    play-time GPIOD->BSRR guard interval g is sufficient, using real
    STM32F407 timing data from RM0090 and PM0214 already in this repo.
    Key findings:
    - RM0090's HTIF/TCIF wording ("once half the data have been
    transferred... the flag is set") means the play-time IRQ actually
    fires one full tick period (250 ns) before the target half's first
    transfer, not simultaneously with it as the prior draft implied -
    a natural head start that shifts the setup-margin inequality from
    g*250ns - L >= 200ns to the more forgiving g >= (L-50ns)/250ns.
    - GPIOD (like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
2026-09-16 Phase 1: STEP/DIR generation engine and motion modules
    Implements the motion subsystem against the frozen decisions in
    Docs/PRE-IMPLEMENTATION-DECISIONS.md and ADR-001..ADR-011, with a
    hardware-validation path for every requirement that cannot be proven in
    software.
    BLOCKING FINDING (ADR-012) - needs a project decision
    The frozen STEP path TIM2_UP -> DMA1_Stream1 -> GPIOA->BSRR, which the
    .ioc is configured for, cannot work on this MCU. RM0090 Rev 22 §2.1 does
    not list the DMA1 *peripheral* bus among the STM32F405xx/07xx bus-matrix
    masters, Figure 33 note 1 says the same, GPIOA is an AHB1 peripheral
    reachable only through the matrix, and §10.3.16/§10.3.17 put DMA_SxPAR on
    the peripheral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
2026-09-16 replace tim8 with tim2
    [CNC5AX-ETH.ioc, lwip.c, lwip.h, main.c]
2026-09-16 Phase 1: integrate motion engine into the CubeIDE project
    Completes Phase 1 against the owner's TIM2 -> TIM8 / DMA1 -> DMA2 change
    (ADR-012, now accepted). The full firmware compiles and links.
    Verified in the pushed .ioc
    - TIM8_UP on DMA2_Stream1, direct mode (FIFO disabled), word width both
    sides, MINC on, PINC off, circular, very high priority
    - NVIC.DMA2_Stream1_IRQn at preempt priority 2, per ADR-004
    - All TIM2 references gone; TIM8's own global interrupt correctly left
    disabled
    - CubeMX independently assigns DMA_CHANNEL_7, matching RM0090 Table 44 -
    an independent corroboration of the ADR-012 reading
    One gap found and fixed: MX_TIM8_Init() carried the CubeMX default
    Period = 65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
    [CNC5AX-ETH.ioc, cnc_motion_config.h, main.c, stepgen.c, stepgen.h, stepgen_core.c, stepgen_hw_map.h, stepgen_port_stm32f4.c]
2026-09-16 Confirm PHY reset pulse width (150us) and elevate two ADR-012 hardening facts to binding rules
    Resolves the last open pre-implementation item and turns two facts that
    were only implicit in ADR-012's STEP-DMA correction into explicit,
    checked requirements, per project-owner direction.
    - ADR-013 (new): PB0/PHY_NRST reset pulse width confirmed at >=150 us
    (deliberate margin over the LAN8720A's ~100us trstia minimum),
    resolving FIRMWARE-IMPLEMENTATION-PLAN.md Section 4 item 8, the last
    of the original eight pre-implementation decisions. Firmware
    implementation (a microsecond-precision delay before low_level_init's
    MDIO access) is noted as a still-open to-do against M12, not a design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
2026-09-17 Fix Ethernet MAC address: use ADR-011's bench address, not the CubeMX vendor placeholder
    low_level_init() in ethernetif.c was still setting MACAddr to CubeMX's
    default 00:80:E1:00:00:00, a real vendor's OUI prefix that ADR-011
    already decided must not ship even for bench testing. Switches it to
    the locally-administered bench address ADR-011 adopted, 02:00:05:10:00:01
    (U/L bit set, echoing the static IP 192.168.5.10 as a memorable
    convention only). Not driven by any .ioc field, so this is a plain code
    fix, not a regenerated-vs-hand-edited conflict.
    Docs/PRE-IMPLEMENTATION-DECISIONS.md item 7 updated to record that this
    half of ADR-011 is now implemented, not just decided.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
2026-09-17 Phase 2: Ethernet/LwIP bring-up (M12)
    Implements M12 - PHY reset, link bring-up, static addressing and the link
    state the rest of the firmware reads. No UDP and no protocol layer: M13
    and M14 remain blocked on the packet format and port number
    (Docs/FIRMWARE-IMPLEMENTATION-PLAN.md section 3).
    The static IP configuration had been silently reverted
    -----------------------------------------------------
    Docs/ETHERNET.md section 15 described the static IPv4 setup as
    [FW-CONFIRMED]. It was, in 438f59f - but every one of those edits sat in a
    CubeMX-generated region, and the regeneration in b409ba5 reverted all of
    them: LWIP_DHCP back to 1, dhcp_start() back in MX_LWIP_Init(), the
    address defines g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
    [CNC5AX-ETH.ioc, lwip.c, lwip.h, main.c, net_config.h, net_glue_stm32f4.c, net_hw_map.h]
2026-09-17 Phase 3: UDP transport and the C5P1 motion protocol (M13/M14)
    Implements the chain the phase called for - test client -> UDP -> lwIP ->
    validation -> session -> motion queue -> DDA -> STEP/DIR - and a PC-side
    client so the firmware's protocol is exercisable without Mach3 or a plugin.
    Docs/PROTOCOL.md is the authoritative wire format; ADR-014 records the
    decisions and the alternatives rejected.
    The evidence, and what it did not settle
    ----------------------------------------
    Re-read SDK/ncPod/ and SDK/Galil PlugIn/ as Docs/MACH3-INTERFACE.md section
    7 required before specifying anything. From ncPod's Send512Block() and
    ncPODDriver.h: time-sliced per-axis velocity rather than GMoves, 32 reco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
2026-09-18 add sdk
    [Decoders.obj, Dmcwin.obj, ExternalMovement.obj, G100Config.obj, G100FLASHCONFIG.obj, G100General.obj, G100Monitor.obj, LocalIPQuery.obj]
2026-09-18 Rewrite SDK-README and MACH3-INTERFACE against the fully extracted Mach3 SDK
    SDK-README.MD was generic "how to work with any SDK" boilerplate written
    before the zip was extracted - it described no actual SDK content.
    Replaced it with a real index of what's under MACH3/: the two MachIncludes
    copies (and the 4 files where they actually differ, verified by diff), and
    an accurate map of all 8 sample plugin projects - which ones have
    ExternalMovement (BlankMovement, Galil PlugIn, ncPod) versus which are
    jog/probing/I/O-only skeletons with no motion device (Blank Plugin,
    JoyStickPlugIn, Probing, ShuttlePro, g100IO), verified by grepping each
    MachDevImplementation.cpp rather than trusting directory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
2026-09-18 Phase 4: digital input manager and the E-STOP path (M3)
    Before this, the fifteen EXTI lines were configured by CubeMX with nothing
    behind them: an E-STOP press produced an interrupt that returned without
    doing anything, STATUS.inputs was a hard zero, and stepgen.h's promise that
    an emergency stop clears "only once the physical input has released" was a
    comment with no code under it. All three are now implemented.
    Decisions are recorded as ADR-015; the five that were left open by
    FIRMWARE-ARCHITECTURE §7/§20:
    - Level-based, never edge-count-based. Every ISR and every poll re-reads
    GPIOE. Five of six input vectors are shared, pending bits coalesce, and
    an E-STOP already held down at po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
2026-09-19 Make the CubeIDE project build on import
    A fresh import of Firmware/ into STM32CubeIDE failed to compile: .cproject
    had never listed the project's own folders, only the four CubeMX-generated
    ones (Core, LWIP, Middlewares, Drivers). So Motion/, Net/, Safety/ and
    Platform/STM32F407/ were neither on the include path nor in the build, and
    the generated files that reach into them could not find their headers:
    LWIP/App/lwip.c:31 fatal error: net_glue.h: No such file or directory
    LWIP/Target/ethernetif.c:36 fatal error: net_config.h: No such file or directory
    Core/Src/main.c:29 fatal error: stepgen.h: No such file or directory
    Core/Src/stm32f4xx_it.c:25 fatal error: safe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
    [stepgen.c]
2026-09-19 Phase 5: output manager and spindle PWM (M9, M10)
    Every firmware module in the implementation plan now exists.
    Before this, MX_TIM3_Init() built a 10 kHz PWM generator that was never
    started, PB8/PB2/PB1 were driven low once at boot and never touched again,
    and the OUTPUTS opcode was answered with NOT_IMPLEMENTED.
    What this adds is not three pins, it is the rule that governs them.
    Decisions are recorded as ADR-016; §21 and §22 left all of them open and
    §22 explicitly delegated the spindle's frequency, duty range, scaling,
    command source and update mechanism:
    - One interlock over relay and spindle, recomputed from the motion
    engine's state on every superloop iteration, never cached. O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
2026-09-25 Review the prototype board schematic and document it
    prototype_test/prototype_sch.pdf is a bench prototype, not the product:
    it carries the Waveshare LAN8720 module and a StepStick driver socket,
    while the final PCB carries the LAN8720A IC (nRST on PB0) and drives
    external industrial drives. Reviewed pin by pin against Docs/PINOUT.md,
    the module schematic, and the STM32F407 / LAN8720A datasheets in the repo.
    What is right: every MCU pin number carrying a net matches the datasheet's
    LQFP100 column (0 symbol errors); every PINOUT.md signal is on its pin;
    the LAN header matches the module's P2 pin for pin, including pin 13 NC;
    BOOT0, NRST, VCAP_1/2, switch wiring and driver coil pairing are co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
    [net_config.h, net_hw_map.h]
2026-09-25 Record owner decisions on the prototype review and driver EN polarity
    PR-1 resolved at assembly (8 MHz fitted; the 16 MHz part was only the
    library symbol), PR-3 fixed by the owner on the PCB, PR-4 deferred to the
    test stage as firmware configuration.
    PR-2 researched: A4988, DRV8825 and TMC2208/2209/2225/2226 are all
    active-low enable, so the firmware's active-high EN (correct against
    PINOUT.md) is inverted on the StepStick socket. That is a firmware fix
    once CNC_EN_ACTIVE_HIGH is honoured. The PCB still wants a 10k pull-up on
    the socket EN net, because PD15 floats during MCU reset and a DRV8825
    reads a floating enable as enabled. Industrial DM542-class drives are
    opto-coupled and also read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
2026-09-25 Make EN polarity a real build switch; re-check the revised prototype
    CNC_EN_ACTIVE_HIGH existed but nothing read it: the STEP port hard-coded
    an active-high EN in three places. Every common StepStick driver is active
    low, and the owner wants to settle the polarity on the bench, so the macro
    now controls every firmware write to PD15 - the boot level, enable,
    disable and the emergency stop. Default stays 1 (active high, PINOUT.md).
    - stepgen_port.h: stepgen_en_pin_level() / stepgen_en_enabled_from_pin(),
    one pure rule, header-inline so the emergency-stop ISR pays no call.
    - stepgen_port_stm32f4.c: en_bsrr() routes all three BSRR stores through
    it. Verified in the image: emergency stop sto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
2026-11-01 Rewrite c5p1.py so every run works, and add its tests
    The old tool started each run at seq 1. The device ignores any seq at or
    below the highest one it has seen (PROTOCOL.md section 4.4), so only the
    first run after a device reset worked: `c5p1.py enable` after
    `c5p1.py info` failed with "HELLO did not return INFO".
    Fixes, each with a test:
    - connect() re-synchronises seq. A HELLO answered with STATUS instead of
    INFO carries last_seq_seen, and the tool continues above it.
    - move re-synchronises block_seq. A second move from a new run no longer
    starts at block 1 while the device is still synced at the first run's
    last block, which it dropped as stale.
    - Replies are matched by their se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
2026-11-11 Make active-low EN the default (CNC_EN_ACTIVE_HIGH 0)
    The owner's drivers are active low (enabled at 0 V). The default was still
    1, so a build without an override drove PD15 the wrong way and disagreed
    with the High initial level now set in gpio.c and the .ioc. Default is 0;
    README, PINOUT, MOTION-README, PHASE1-STATUS and the validation plan now
    say so. The EN polarity host tests already cover both values.
    Claude-Session: https://claude.ai/code/session_01UjY8vQdcHzimYVWzpueejQ
