elieassjaj/Mach3-based-industrial-CNC-controller/(notices)

Notices in the files:
Firmware/LWIP/App/lwip.c:
Copyright (c) 2026 STMicroelectronics.
All rights reserved.
This software is licensed under terms that can be found in the LICENSE file
